adafruit/Adafruit-SPI-Flash-Breakout/SPI Flash Rev E.brd

## EAGLE design SPI Flash Rev E.brd (2022-11-14)

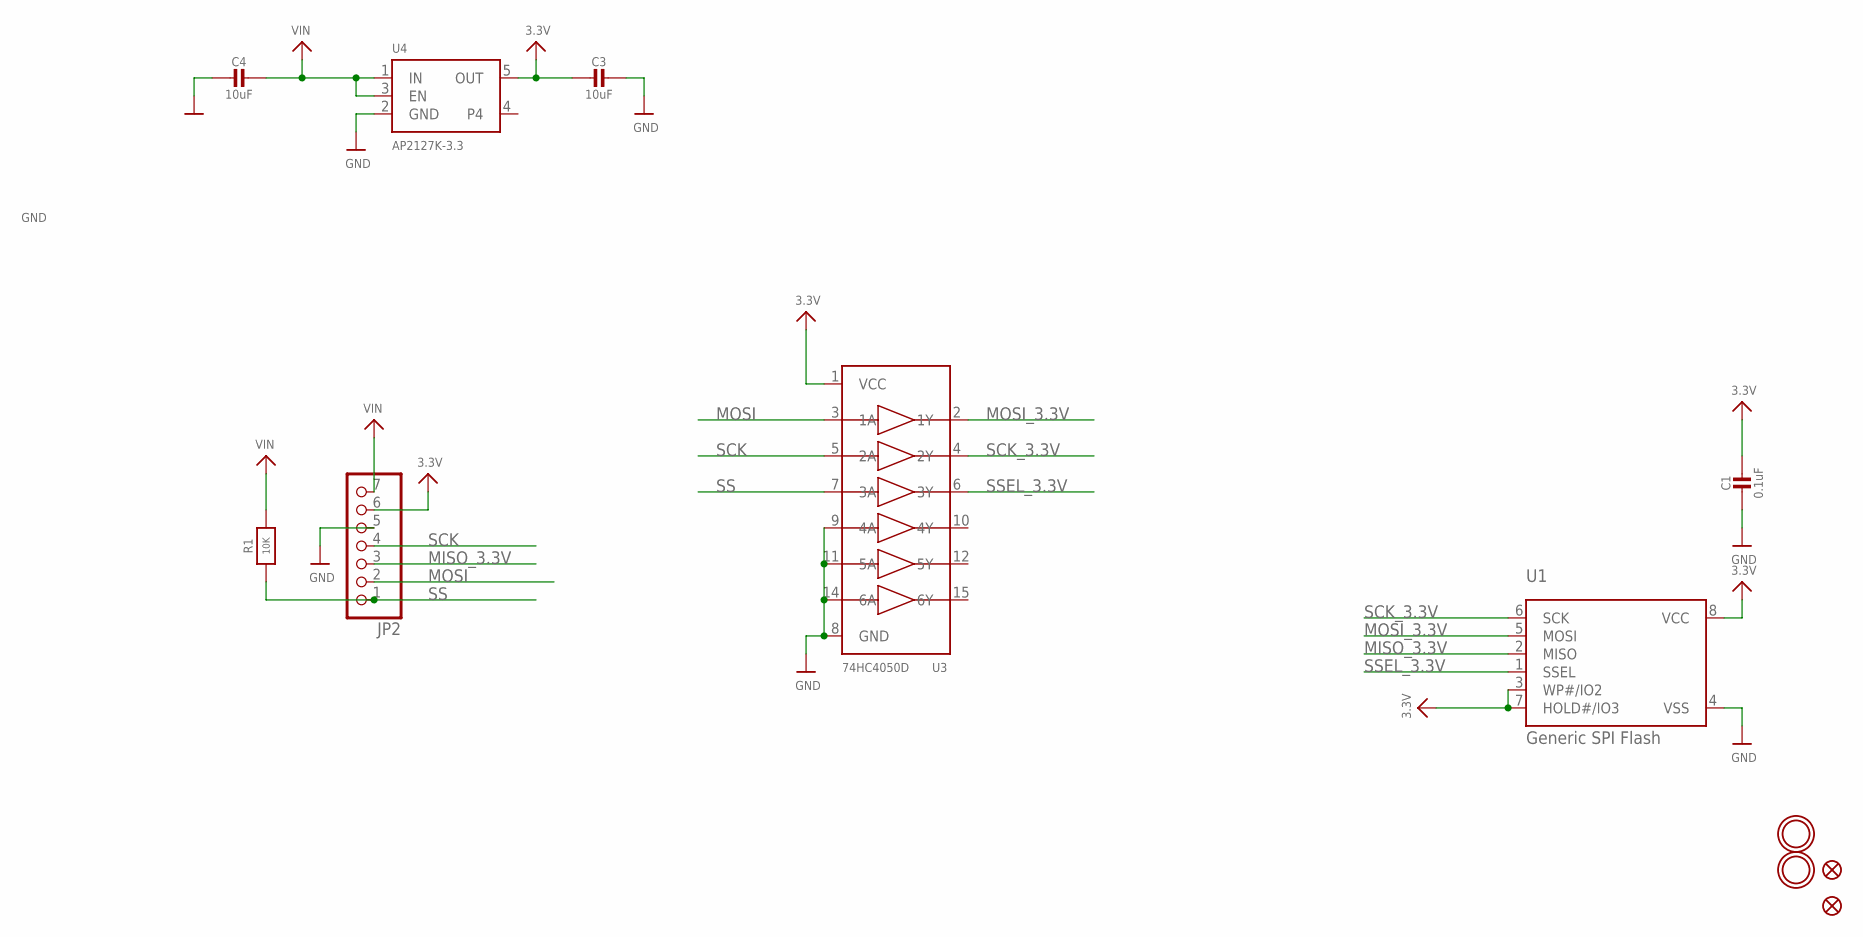
[picture p4: schematic SPI Flash Rev E.sch]

Parts:
C1: 0.1uF; 0603-NO
C3, C4: 10uF; 0805-NO
FID2, FID3: FIDUCIAL_1MM
JP2: HEADER-1X770MIL; 1X07_ROUND_70
R1: 10K; 0603-NO
U1: Generic SPI Flash; SOIC8_208MIL
U3: 74HC4050D; TSSOP16
U4: AP2127K-3.3; SOT23-5
U$16, U$17: MOUNTINGHOLE2.5; MOUNTINGHOLE_2.5_PLATED

Connections:
3.3V: C1.1, C3.2, JP2.6, U1.3 (WP#/IO2), U1.7 (HOLD#/IO3), U1.8 (VCC), U3.1 (VCC), U4.5 (OUT)
GND: C1.2, C3.1, C4.2, JP2.5, U1.4 (VSS), U3.8 (GND), U3.9 (4A), U3.11 (5A), U3.14 (6A), U4.2 (GND)
MISO_3.3V: JP2.3, U1.2 (MISO)
MOSI: JP2.2, U3.3 (1A)
MOSI_3.3V: U1.5 (MOSI), U3.2 (1Y)
SCK: JP2.4, U3.5 (2A)
SCK_3.3V: U1.6 (SCK), U3.4 (2Y)
SS: JP2.1, R1.1, U3.7 (3A)
SSEL_3.3V: U1.1 (SSEL), U3.6 (3Y)
VIN: C4.1, JP2.7, R1.2, U4.1 (IN), U4.3 (EN)

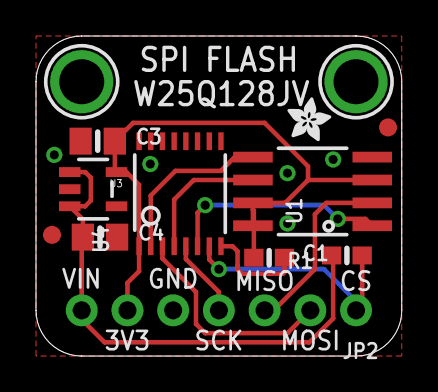
[picture p5: board SPI Flash Rev E.brd from above]

Board: 2 copper layers, 20.3 x 17.8 mm, 14 parts (1 on the bottom side), 10 nets.

Other parts of the board:
U$13: ADAFRUIT_2.5MM
U$21: PCBFEAT-REV-040
